eddbrds/Jaye44/README.md

# Jaye44
Build guide and firmware files

[V0.0 Buildguide](https://github.com/e2dwrd/Jaye44/tree/main/docs/buildguides)

[Firmware](https://github.com/e2dwrd/Jaye44/tree/main/docs/firmwares)

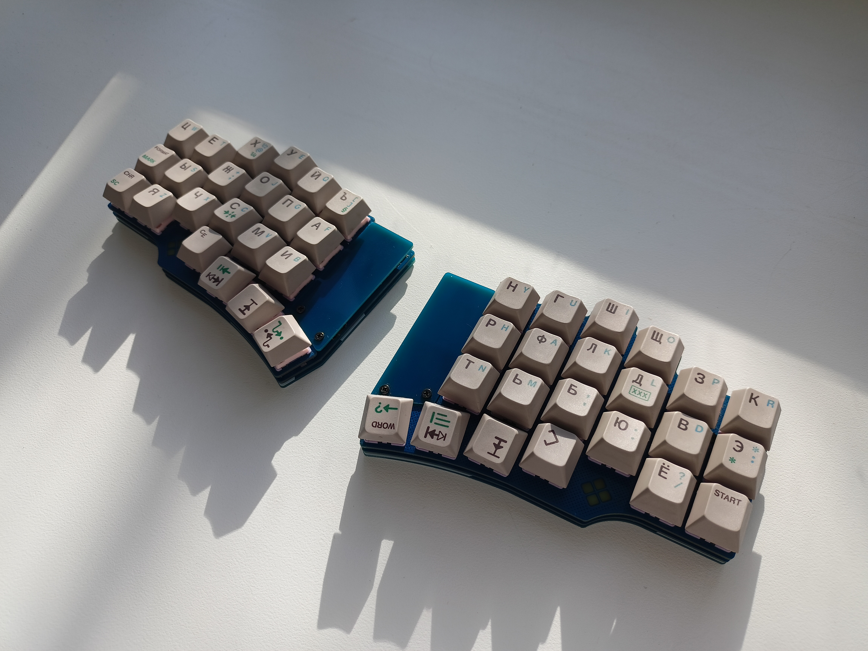
[picture p1: images/XEROX6012PH1.jpg]
