eddbrds/Jaye44/images/XEROX6012PH2.jpg

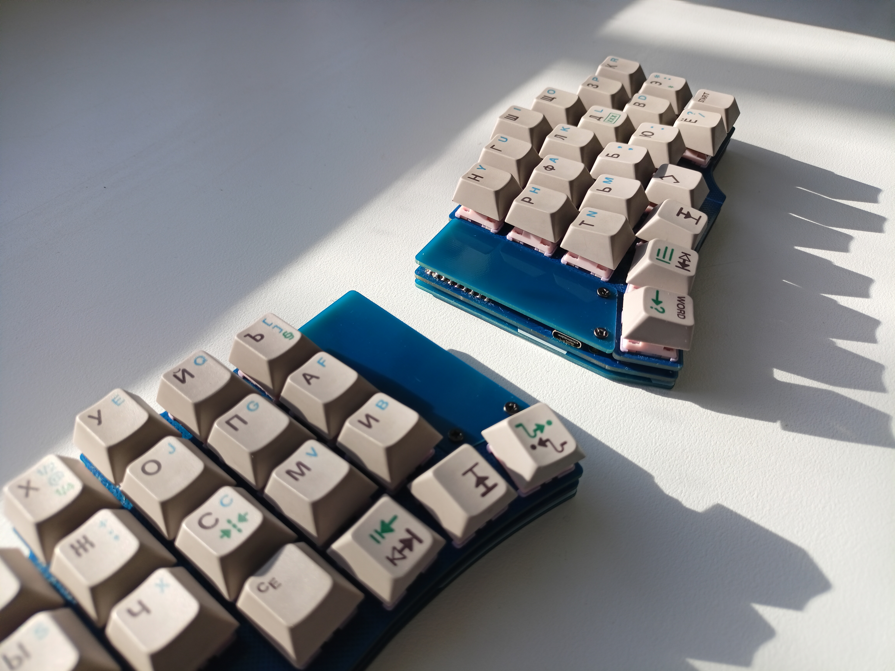
images/XEROX6012PH2.jpg
