eddbrds/Jaye44/hardware/case and other parts/foam dxf/plate foam.dxf

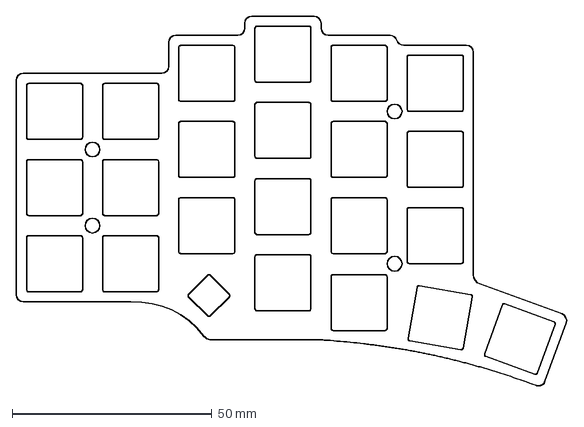
[picture p3: CAD file, 2023-11-18]
hardware/case and other parts/foam dxf/plate foam.dxf
137.9 x 92.7 mm
