eddbrds/Jaye44/hardware/case and other parts/Jaye_44_case_3DP.step

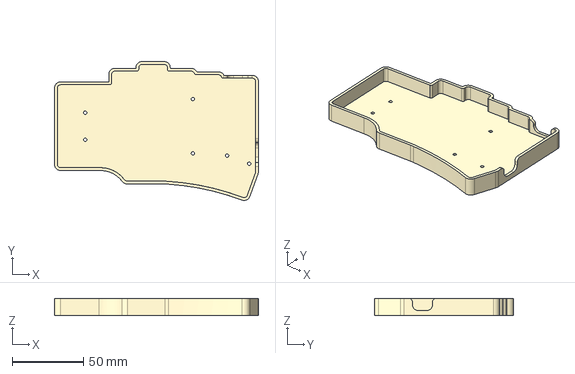
[picture p4: CAD file, 2024-01-25]
hardware/case and other parts/Jaye_44_case_3DP.step
143.2 x 97.5 x 12.1 mm
