eddbrds/Jaye44/hardware/case and other parts/foam dxf/backplate v0.0 foam.dxf

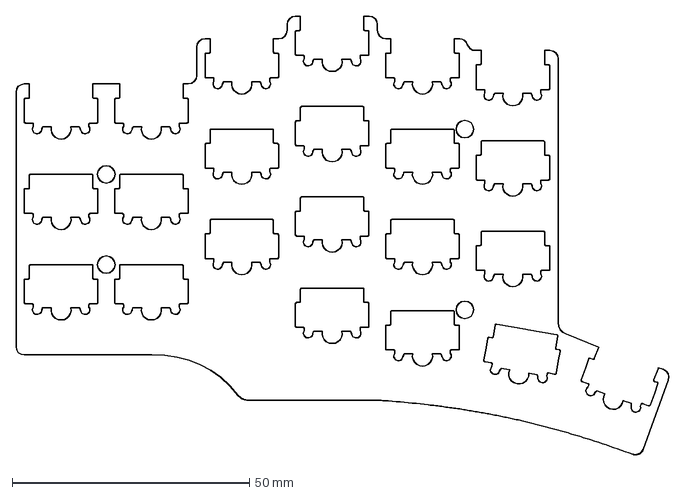
[picture p5: CAD file, 2023-11-18]
hardware/case and other parts/foam dxf/backplate v0.0 foam.dxf
137.9 x 92.7 mm
