eddbrds/Jaye44/hardware/case and other parts/Jaye_44_plate_3DP.step

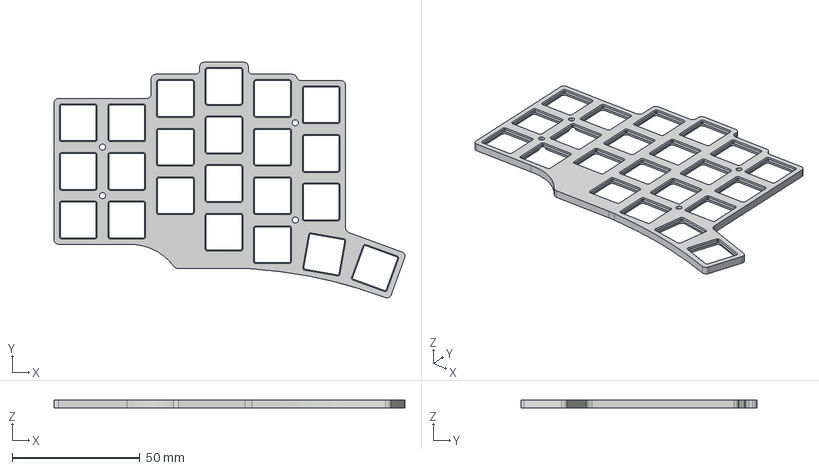
[picture p6: CAD file, 2024-01-25]
hardware/case and other parts/Jaye_44_plate_3DP.step
137.7 x 92.5 x 3.00 mm
