eddbrds/Jaye44/hardware/case and other parts/foam dxf/shield v0.0 foam.dxf

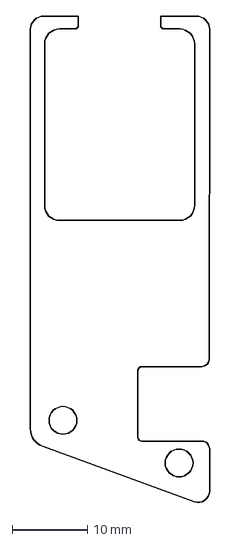
[picture p7: CAD file, 2023-11-18]
hardware/case and other parts/foam dxf/shield v0.0 foam.dxf
23.8 x 64.8 mm
