eddbrds/Jaye44/hardware/case and other parts/Jaye_44_shield_3DP.step

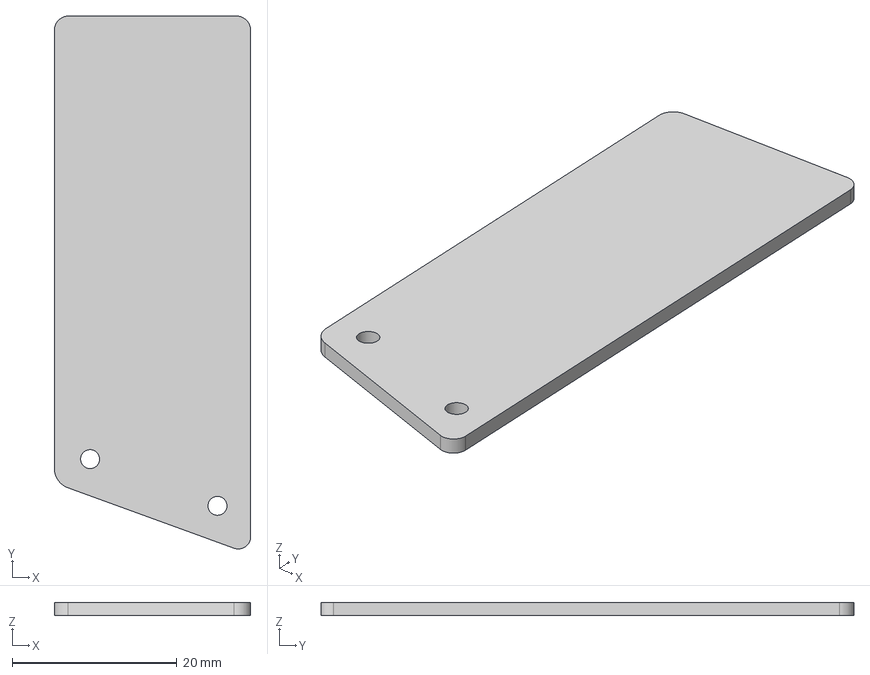
[picture p8: CAD file, 2024-01-25]
hardware/case and other parts/Jaye_44_shield_3DP.step
23.8 x 64.7 x 1.60 mm
