eddbrds/Jaye44/docs/buildguides/images/adding_solder_on_pad.jpg

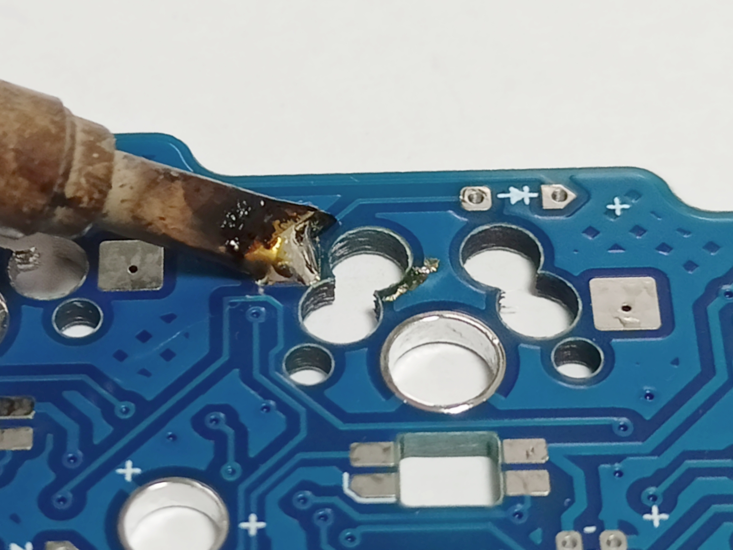
docs/buildguides/images/adding_solder_on_pad.jpg
