eddbrds/Jaye44/docs/buildguides/images/adding_solder_on_usb_lines_pads.jpg

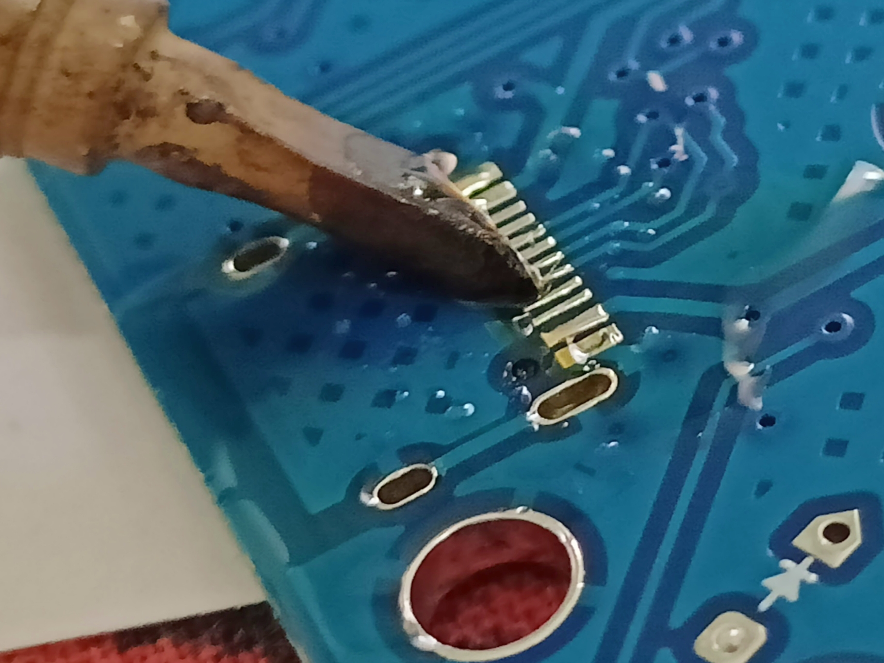
docs/buildguides/images/adding_solder_on_usb_lines_pads.jpg
