eddbrds/Jaye44/(commit log)

2023-11-18 Update and rename Jaye 44 case for v0.0_.step to Jaye 44 case for v0.0_.step
    [Jaye 44 case for v0.0_.step]
2023-11-18 Update and rename hardware/foam dxf/plate foam.dxf to hardware/case and other parts/foam dxf/plate foam.dxf
    [plate foam.dxf]
